genoswitch/software-judging/hardware/hardware/README.md

# hardware

Repository containing the KiCad 7.0 project for the hardware design.

Very early stages of development

## License
This repository is licensed under the **Open Hardware Licence Version 2 - Weakly Reciprocal** (SPDX: `CERN-OHL-W-2.0`)

However, the `lib/` folder contains parts that are subject to their own licenses.
