genoswitch/software-judging/hardware/firmware/src/flashloader/ihex/README.md

The code in this ihex directory is heavily based on the pico-flashloader example implementation available at

https://github.com/rhulme/pico-flashloader/.

pico-flashloader is licensed under BSD-3-Clause.

Therefore, all files in this folder are licensed under BSD-3-Clause.
