genoswitch/software-judging/hardware/hardware/clearances.ods

 | (mm) | PCBWay (absolute min) | PCBWay (recommended, cheaper) | JLCPCB | OSHPark | V-scoring | OLD | HIGHEST
Copper | Minimum clearance | 0.1 | 0.15 |  | 0.1524 |  | 0.1524 | 0.1524
 | Minimum track width | 0.1 | 0.15 | 0.127 | 0.1524 |  | 0.1524 | 0.1524
 | Minimum connection width | 0.1 | 0.15 |  | 0.1524 |  | 0.1524 | 0.1524
 | Minimum annnular width | 0.15 |  | 0.3? | 0.127 |  | 0..13 | 0.15
 | Minimum via diameter |  |  |  | 0.508 |  | 0.508 | 0.508 | 0.6 for matching with annular width
 | Copper to hole clearance |  |  |  | 0.127 |  | 0.127 | 0.127
 | Copper to edge clearance |  |  |  |  | 1 | 0..13 | 1
Holes | Minimum through hole |  |  | 0.3 | 0.254 |  | 0.254 | 0.3
 | Hole to hole clearance |  |  | 0.5 | 0.127 |  | 0.254 | 0.5
uVias | Minimum uVia diameter |  |  | 0.5 | 0.508 |  | 0.508 | 0.508
 | Minimum uVia hole |  |  | 0.3 | 0.254 |  | 0.254 | 0.3
Silkscreen | Minimum item clearance |  |  |  |  |  | 0 | 0
 | Minimum text height | 0.8 |  |  |  |  | 1 | 1
 | Minimum text thickness | 0.15 |  |  | 0.127 |  | 0.153 | 0.153
 |  |  |  |  |  | Annular ring is smallest copper dimension minus by drill diameter divided by two. |  | 0.3
 |  |  |  |  | -0.508 |  | dia | 0.6
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
