genoswitch/software-judging/hardware/hardware/genoswitch-rp2040/genoswitch-rp2040.kicad_pcb

## KiCad design hardware/hardware/genoswitch-rp2040/genoswitch-rp2040.kicad_pcb (2023-10-07)

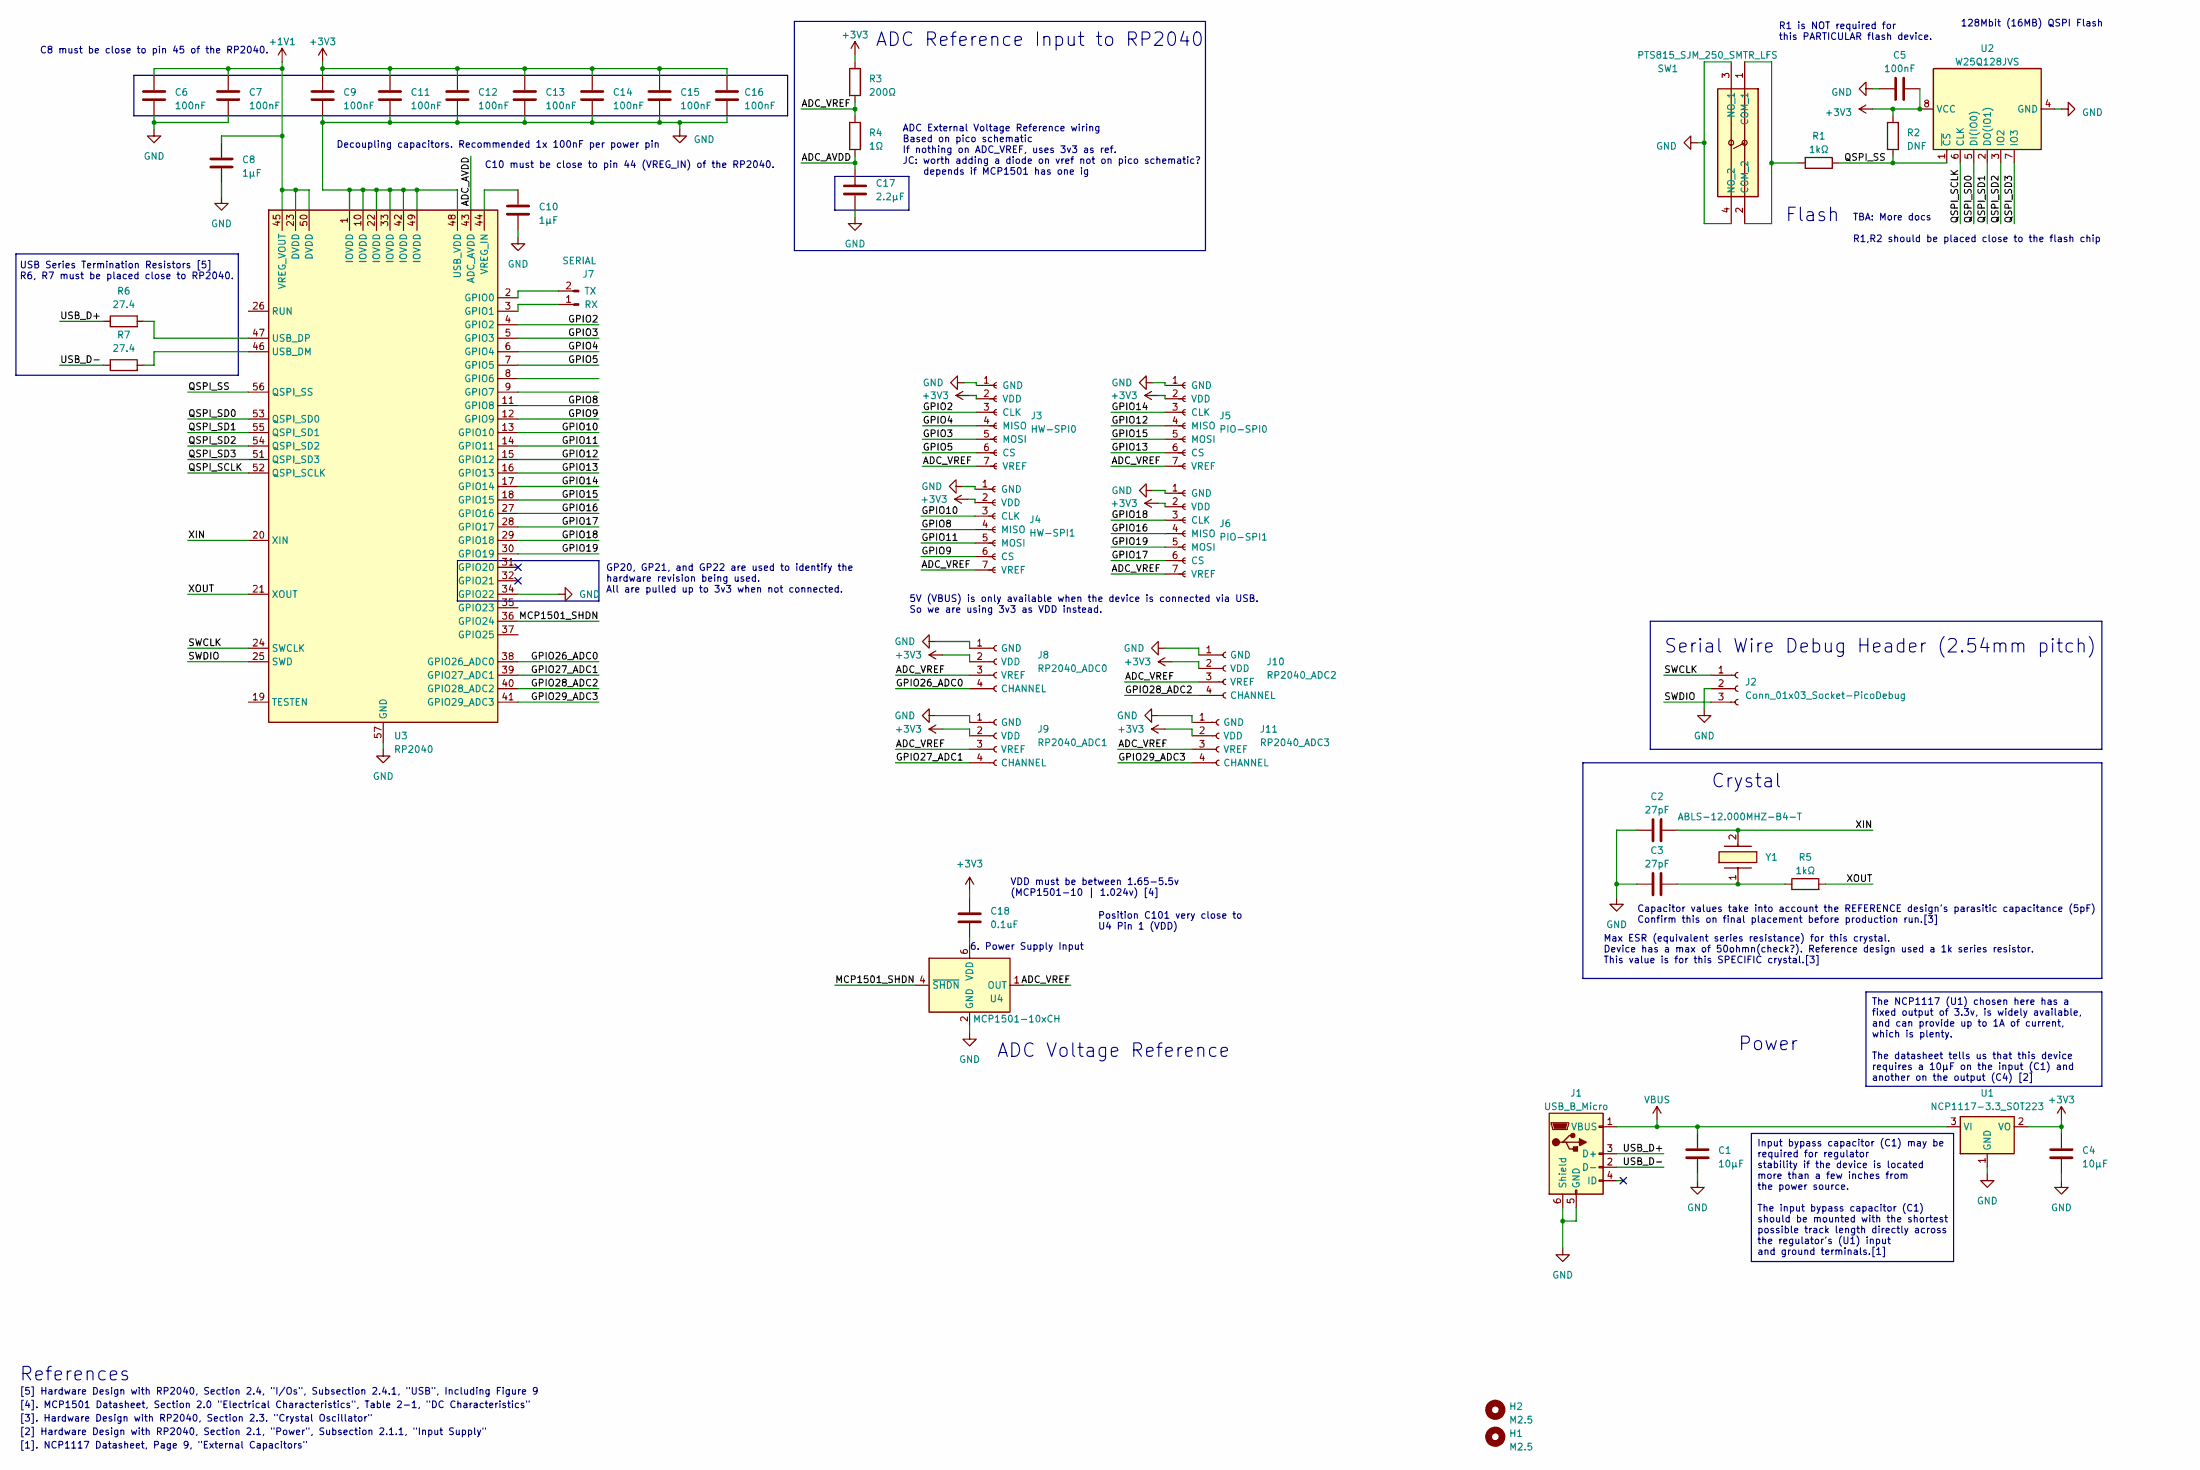
[picture p1: schematic genoswitch-rp2040.kicad_sch]

Parts:
C1, C4: 10μF; C_0201_0603Metric
C2, C3: 27pF; C_0201_0603Metric
C5, C6, C7, C9, C11, C12, C13, C14, C15, C16: 100nF; C_0201_0603Metric
C8, C10: 1μF; C_0201_0603Metric
C17: 2.2μF; C_0201_0603Metric
C18: 0.1uF; C_0201_0603Metric
H1, H2: M2.5; MountingHole_2.7mm_M2.5_Pad_TopBottom
J1: USB_B_Micro; USB_Micro-B_Amphenol_10118193-0001LF_Horizontal
J2: Conn_01x03_Socket-PicoDebug; PinHeader_1x03_P2.54mm_Vertical
J3: HW-SPI0; JST_PH_S7B-PH-K_1x07_P2.00mm_Horizontal
J4: HW-SPI1; JST_PH_S7B-PH-K_1x07_P2.00mm_Horizontal
J5: PIO-SPI0; JST_PH_S7B-PH-K_1x07_P2.00mm_Horizontal
J6: PIO-SPI1; JST_PH_S7B-PH-K_1x07_P2.00mm_Horizontal
J7: SERIAL; PinHeader_1x02_P2.54mm_Vertical
J8: RP2040_ADC0; JST_PH_S4B-PH-K_1x04_P2.00mm_Horizontal
J9: RP2040_ADC1; JST_PH_S4B-PH-K_1x04_P2.00mm_Horizontal
J10: RP2040_ADC2; JST_PH_S4B-PH-K_1x04_P2.00mm_Horizontal
J11: RP2040_ADC3; JST_PH_S4B-PH-K_1x04_P2.00mm_Horizontal
R1, R5: 1kΩ; R_0201_0603Metric
R2: DNF; R_0201_0603Metric
R3: 200Ω; R_0201_0603Metric
R4: 1Ω; R_0201_0603Metric
R6, R7: 27.4; R_0201_0603Metric
SW1: PTS815_SJM_250_SMTR_LFS; PTS815SJM250SMTRLFS; Mouser Part Number 611-PTS815SJM250SMTR
U1: NCP1117-3.3_SOT223; SOT-223-3_TabPin2
U2: W25Q128JVS; SOIC-8_5.23x5.23mm_P1.27mm
U3: RP2040; QFN-56-1EP_7x7mm_P0.4mm_EP3.2x3.2mm
U4: MCP1501-10xCH; SOT-23-6
Y1: ABLS-12.000MHZ-B4-T; ABLS; Mouser Part Number 815-ABLS-12.0M-T

Connections:
+1V1: C6.1, C7.1, C8.1, U3.23 (DVDD), U3.45 (VREG_VOUT), U3.50 (DVDD)
+3V3: C4.1, C5.2, C9.1, C11.1, C12.1, C13.1, C14.1, C15.1, C16.1, C18.2, J3.2 (VDD), J4.2 (VDD), J5.2 (VDD), J6.2 (VDD), J8.2 (VDD), J9.2 (VDD), J10.2 (VDD), J11.2 (VDD), R2.2, R3.1, U1.2 (VO), U2.8 (VCC)
/ADC_AVDD: C17.1, R4.2, U3.43 (ADC_AVDD)
/ADC_VREF: J3.7 (VREF), J4.7 (VREF), J5.7 (VREF), J6.7 (VREF), J8.3 (VREF), J9.3 (VREF), J10.3 (VREF), J11.3 (VREF), R3.2, R4.1, U4.1 (OUT)
/GPIO4: J3.4 (DOUT), U3.6 (GPIO4)
/GPIO5: J3.6 (CS), U3.7 (GPIO5)
/GPIO6: J3.3 (CLK), U3.4 (GPIO2), U3.8 (GPIO6)
/GPIO7: J3.5 (DIN), U3.5 (GPIO3), U3.9 (GPIO7)
/GPIO8: J4.4 (DOUT), U3.11 (GPIO8)
/GPIO9: J4.6 (CS), U3.12 (GPIO9)
/GPIO10: J4.3 (CLK), U3.13 (GPIO10)
/GPIO11: J4.5 (DIN), U3.14 (GPIO11)
/GPIO12: J5.4 (DOUT), U3.15 (GPIO12)
/GPIO13: J5.6 (CS), U3.16 (GPIO13)
/GPIO14: J5.3 (CLK), U3.17 (GPIO14)
/GPIO15: J5.5 (DIN), U3.18 (GPIO15)
/GPIO16: J6.4 (DOUT), U3.27 (GPIO16)
/GPIO17: J6.6 (CS), U3.28 (GPIO17)
/GPIO18: J6.3 (CLK), U3.29 (GPIO18)
/GPIO19: J6.5 (DIN), U3.30 (GPIO19)
/GPIO26_ADC0: J8.4 (CHANNEL), U3.38 (GPIO26_ADC0)
/GPIO27_ADC1: J9.4 (CHANNEL), U3.39 (GPIO27_ADC1)
/GPIO28_ADC2: J10.4 (CHANNEL), U3.40 (GPIO28_ADC2)
/GPIO29_ADC3: J11.4 (CHANNEL), U3.41 (GPIO29_ADC3)
/MCP1501_SHDN: U3.36 (GPIO24), U4.4 (~SHDN)
/QSPI_SCLK: U2.6 (CLK), U3.52 (QSPI_SCLK)
/QSPI_SD0: U2.5 (DI(IO0)), U3.53 (QSPI_SD0)
/QSPI_SD1: U2.2 (DO(IO1)), U3.55 (QSPI_SD1)
/QSPI_SD2: U2.3 (IO2), U3.54 (QSPI_SD2)
/QSPI_SD3: U2.7 (IO3), U3.51 (QSPI_SD3)
/QSPI_SS: R1.1, R2.1, U2.1 (~CS), U3.56 (QSPI_SS)
/SWCLK: J2.1, U3.24 (SWCLK)
/SWDIO: J2.3, U3.25 (SWD)
/USB_D+: J1.3 (D+), R6.1
/USB_D-: J1.2 (D-), R7.1
/XIN: C2.2, U3.20 (XIN), Y1.2
/XOUT: R5.2, U3.21 (XOUT)
GND: C1.2, C2.1, C3.1, C4.2, C5.1, C6.2, C7.2, C8.2, C9.2, C10.2, C11.2, C12.2, C13.2, C14.2, C15.2, C16.2, C17.2, J1.5 (GND), J1.6 (Shield), J2.2, J3.1 (GND), J4.1 (GND), J5.1 (GND), J6.1 (GND), J8.1 (GND), J9.1 (GND), J10.1 (GND), J11.1 (GND), SW1.3 (NO_1), SW1.4 (NO_2), U1.1 (GND), U2.4 (GND), U3.1 (IOVDD), U3.10 (IOVDD), U3.22 (IOVDD), U3.33 (IOVDD), U3.34 (GPIO22), U3.42 (IOVDD), U3.48 (USB_VDD), U3.49 (IOVDD), U3.57 (GND), U4.2 (GND), U4.3 (GND), U4.5 (GND)
unnamed: C3.2, R5.1, Y1.1
unnamed: J7.1 (RX), U3.3 (GPIO1)
unnamed: J7.2 (TX), U3.2 (GPIO0)
unnamed: R1.2, SW1.1 (COM_1), SW1.2 (COM_2)
unnamed: R7.2, U3.46 (USB_DM)
unnamed: R6.2, U3.47 (USB_DP)
unnamed: C10.1, U3.44 (VREG_IN)
unnamed: C18.1, U4.6 (VDD)
VBUS: C1.1, J1.1 (VBUS), U1.3 (VI)

Notes on the sheet:
The NCP1117 (U1) chosen here has a fixed output of 3.3v, is widely available, and can provide up to 1A of current, which is plenty. The datasheet tells us that this device requires a 10μF on the input (C1) and another on the output (C4) [2]
Input bypass capacitor (C1) may be required for regulator stability if the device is located more than a few inches from the power source. The input bypass capacitor (C1) should be mounted with the shortest possible track length directly across the regulator's (U1) input and ground terminals.[1]
VDD must be between 1.65-5.5v (MCP1501-10 | 1.024v) [4]
6. Power Supply Input
5V (VBUS) is only available when the device is connected via USB. So we are using 3v3 as VDD instead.
[4]. MCP1501 Datasheet, Section 2.0 "Electrical Characteristics", Table 2-1, "DC Characteristics"
Position C101 very close to U4 Pin 1 (VDD)
[5] Hardware Design with RP2040, Section 2.4, "I/Os", Subsection 2.4.1, "USB", Including Figure 9
128Mbit (16MB) QSPI Flash
USB Series Termination Resistors [5] R6, R7 must be placed close to RP2040.
[3]. Hardware Design with RP2040, Section 2.3. "Crystal Oscillator"
Decoupling capacitors. Recommended 1x 100nF per power pin
GP20, GP21, and GP22 are used to identify the hardware revision being used. All are pulled up to 3v3 when not connected.
Power
Serial Wire Debug Header (2.54mm pitch)
Crystal
R1 is NOT required for this PARTICULAR flash device.
[1]. NCP1117 Datasheet, Page 9, "External Capacitors"
ADC Voltage Reference
C10 must be close to pin 44 (VREG_IN) of the RP2040.
ADC External Voltage Reference wiring Based on pico schematic If nothing on ADC_VREF, uses 3v3 as ref. JC: worth adding a diode on vref not on pico schematic? depends if MCP1501 has one ig
TBA: More docs R1,R2 should be placed close to the flash chip
C8 must be close to pin 45 of the RP2040.
ADC Reference Input to RP2040
Capacitor values take into account the REFERENCE design's parasitic capacitance (5pF) Confirm this on final placement before production run.[3]
Max ESR (equivalent series resistance) for this crystal. Device has a max of 50ohmn(check?). Reference design used a 1k series resistor. This value is for this SPECIFIC crystal.[3]
Flash
[2] Hardware Design with RP2040, Section 2.1, "Power", Subsection 2.1.1, "Input Supply"
References

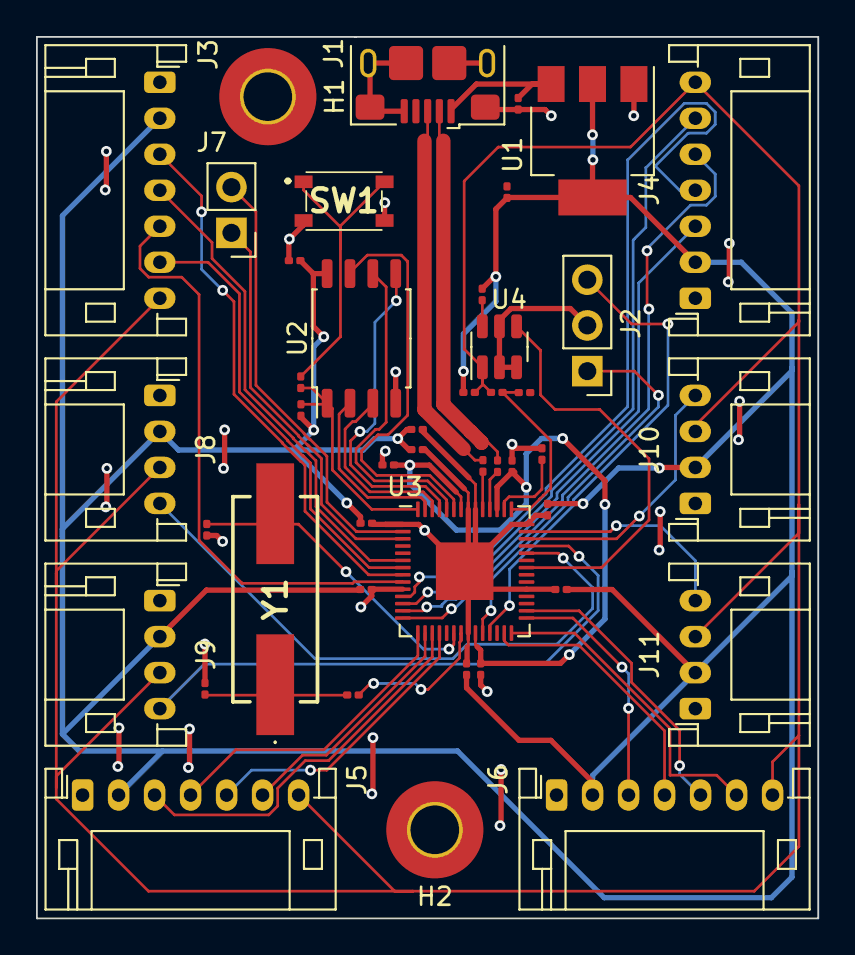
[picture p2: board genoswitch-rp2040.kicad_pcb from above]

Board: 2 copper layers, 43.4 x 49.0 mm, 44 parts (0 on the bottom side), 47 nets.
