genoswitch/software-judging/hardware/firmware/src/flashloader/ihex/util.c

#include <stdint.h>

// Converts an ASCII hex character into its binary representation.
// The existing value is shifted across one nibble before the new value is
// stored in the lower nibble.
// Returns non-zero if the character could be converted
static int hex2nibble(char c, uint8_t *value)
{
    int success = 0;

    if (c >= '0' && c <= '9')
    {
        *value <<= 4;
        *value |= (uint8_t)(c - '0');
        success = 1;
    }
    else
    {
        c |= 32;
        if (c >= 'a' && c <= 'z')
        {
            *value <<= 4;
            *value |= (uint8_t)(c - 'a') + 10;
            success = 1;
        }
    }

    return success;
}

// Converts two ASCII hex characters to an 8-bit binary value.
// Returns non-zero if valid hex characters were found
static int parseHex(const char *str, uint8_t *value)
{
    int success;

    *value = 0;
    success = hex2nibble(*str++, value) && hex2nibble(*str, value);

    return success;
}
