genoswitch/software-judging/(commit log)

2023-01-25 (lib) Add pico-sdk submodule
2023-01-25 Create CMakeList capable of building pico-examples/blink
2023-01-28 Add comments, move prototypes to .h file
2023-01-28 Add tinyusb submodule using master branch
    pico-sdk uses an old version of tinyusb
2023-02-17 Initial support for exchanging messages using a custom request number similar to how webusb landing page(s) are transmitted
2023-02-18 Add unique (board) id vendor command
2023-03-11 POC mcu temp task using ADC channel 4
2023-03-23 (lib) Add pico-flashloader submodule
2023-03-24 (cmake): PoC new way of combining binaries
    This method is based off of picowota (https://github.com/usedbytes/picowota) as well as the pico sdk itself.
    With this method we can create all of the expected output files (.elf, .hex, .uf2) as well as register it as an executable in cmake.
    This commit is just a proof of concept, in later commits this will be extended to have the functionality described above.
2023-03-25 (cmake): Move pico sdk import to root CMakeLists
2023-03-25 (linker): pico-flashloader requires application to have boot2
    Unlike picowota, pico-flashloader uses boot2 to identify the start of image. If space is a concern we could change this behaviour to use a magic string like picowota instead.
2023-04-06 (linker|cmake): Place the flashloader inside the main binary
    In this commit we switch from placing the application in the flashloader to placing the flashloader in the application.
    This makes it easier to debug the application as debug symbols are already in the correct location, at the expense of losing easy debugging for the flashloader.
    Prior to this commit it was difficult to debug the application with the flashloader as the debug symbols did not line up.
2023-04-09 Move core/main files into own directory to prep for library creation
    In this commit I have moved the 'core' code to a seperate folder.
    This is to prep for the creation of a library that can be linked to in order to produce different variants of the firmware (boards, with/without flashloader)
2023-04-09 (core/main): PoC printfs showing flashloader status
2023-04-09 (lib): Update pico-sdk to release v1.5.0
2023-04-09 Use pico optimized versions of standard libraries
2023-04-11 (flashloader): Create DMA standard crc32 func
2023-04-11 (flashloader): Add required tusb dfu callbacks for device to successfully enumerate
    With this commit the device is sucessfully enumerated and now presents a DFU interface. However, on Windows no driver is given to this interface so it cannot be claimed by WebUSB.
    In Linux/macOS, this is not a problem.
    To fix this, we must modify the Microsoft OS 2.0 descriptors to add an additional function subset header for the new interface.
    For more information on the function subset header please visit: https://github.com/newaetech/naeusb/blob/main/wcid.md#function-subset-header
2023-04-11 (core/tusb-conf): Add define scoped MS OS 2.0 values for DFU interface.
    NOTE: At the moment, this change breaks the USB enumeration. I am curious to see if it is because of the size of "desc_ms_os_20".
    Regardless, running this commit results in the pico panicking with the tusb error "ep 0 out was already available".
    I will set up a example version of this so see if it can be duplicated outside of this repo, and if so, submit a bug to TinyUSB.
2023-05-06 (ci): Switch to a matrix, upload artifacts to github pages
2023-05-13 Init KiCad project
    [genoswitch-rp2040.kicad_pcb, genoswitch-rp2040.kicad_sch]
2023-05-13 Add initial power circuitry from minimal design example
    [genoswitch-rp2040.kicad_sch]
2023-05-14 Move power components, add text boxes and references
    [genoswitch-rp2040.kicad_sch]
2023-05-14 Add RP2040 using default package for now
    Note that the minimal example uses a different KiCad package
    [genoswitch-rp2040.kicad_sch]
2023-05-14 Start work on decoupling capacitors for power pins
    [genoswitch-rp2040.kicad_sch]
2023-05-14 Add initial ihex parsing code (based on rhulme/pico-flashloader)
2023-05-15 (lib/pico-flashloader): Switch to fork with patch commit
2023-05-18 (symbols): Split out pins with the same function
    IOVDD, other have multiple pins. On the stock symbol they are combined into a single pin
2023-05-18 Switch to new custom rp2040 part
    [genoswitch-rp2040.kicad_sch]
2023-05-18 Move schematic components around
    [genoswitch-rp2040.kicad_sch]
2023-05-18 Add decoupling capacitors for IOVDD pins
    [genoswitch-rp2040.kicad_sch]
2023-05-18 Add 16MB QSPI chip
    [genoswitch-rp2040.kicad_sch]
2023-05-19 Add crystal (reference design for now)
    [genoswitch-rp2040.kicad_sch]
2023-06-04 (flashloader/ihex/process): Add addr debug print, print ulba when ext lin addr encountered
2023-06-07 (flashloader/ihex/process): Add note about failure condition
    [process.c]
2023-06-07 (flashloader/combined): Create sectioned hex files.
    The stock .hex file contains two sections, the flashloader, starting at 0x10000000, and the application, currently starting at 0x10001000.
    At present only the application is updated when using the DFU mode, so we need a way to only write the application to the flash.
    We could hardcode offsets in the firmware but that would make it difficult when the offset is changed.
    Instead, we are making seperate .hex files for each of the two sections.
    We can then use micro:bit's universal hex format to merge them together in a way where we can clearly identify when each section starts without relying on fixed addresses.
2023-06-08 (flashloader/combined): Use correct env var when printing npm exec path
2023-06-08 (flashloader/main): Switch to crc32 header for include
2023-06-09 (core/main): Print to console if app has updated
2023-06-09 (flashloader/ihex/process): Adjust comments, print debug statements
2023-06-10 (rtos/config): Use a single core for now as tasks are not yet thread-safe
2023-06-10 Add ADC semaphore mutex for mcu_temp task
2023-06-11 Add an MCP1501-10 voltage reference controlled by GP22
    [genoswitch-rp2040.kicad_sch]
2023-06-11 Increase schematic size to A3 (was A4)
    [genoswitch-rp2040.kicad_sch]
2023-06-11 Correctly wire MCP1501 as ADC_VREF based on pico schematic
    [genoswitch-rp2040.kicad_sch]
2023-06-13 Add M2.5 mounting holes (same as Pi Pico)
    [genoswitch-rp2040.kicad_sch]
2023-06-13 Ground RP2040 chip
    [genoswitch-rp2040.kicad_sch]
2023-06-14 (tusb): Switch to new pid.codes pid/vid assignment
2023-06-14 (ci/mirror/merge): Switch to pre-made action
2023-07-10 (lib): Update pico-sdk to version 1.5.1
2023-07-16 note that regulator is U1
    [genoswitch-rp2040.kicad_sch]
2023-07-17 Add a Serial Wire Debug header
    [genoswitch-rp2040.kicad_sch]
2023-07-17 Add HW SPI MCP3008s
    [genoswitch-rp2040.kicad_sch]
2023-07-17 Add PIO SPI MCP3008s
    [genoswitch-rp2040.kicad_sch]
2023-07-17 Change MCP1501_SHDN to GP24
    [genoswitch-rp2040.kicad_sch]
2023-07-18 Add 0201/0603M footprints for resistors, capacitors
    [genoswitch-rp2040.kicad_sch]
2023-07-18 Add footprint for Micro-USB 10118193-0001LF
    [genoswitch-rp2040.kicad_sch]
2023-07-18 Add footprint for C2, C3
    [genoswitch-rp2040.kicad_sch]
2023-07-18 Switch SW1 to PTS815 SJM 250 SMTR LFS; add part library
    [genoswitch-rp2040.kicad_sch]
2023-07-18 (ci/github): Switch to new mirror action
2023-08-05 Move hardware repos to hardware/
    [genoswitch-rp2040.kicad_pcb, genoswitch-rp2040.kicad_sch]
2023-08-07 Add a custom symbol for the B7B-PH-K-S ADC connector
2023-08-07 Remove MCP3008s from main PCB, add connectors instead
    [genoswitch-rp2040.kicad_sch]
2023-08-07 Add missing connections to RP2040 SoC
    [genoswitch-rp2040.kicad_sch]
2023-08-07 Add device detection pin connections
    [genoswitch-rp2040.kicad_sch]
2023-08-08 Add ability to determine device type using 3 GPIOs
2023-08-08 (core/main): Adjust serial printfs
2023-08-08 Change 0603 components to 0402 sizes
    [genoswitch-rp2040.kicad_sch]
2023-08-08 Add serial header to RP2040
    [genoswitch-rp2040.kicad_sch]
2023-08-08 Initial partial layout
    [genoswitch-rp2040.kicad_pcb]
2023-08-08 Place all components in rough positions
    [genoswitch-rp2040.kicad_pcb]
2023-08-08 Swap to horizonal JST PH connector
    [genoswitch-rp2040.kicad_pcb, genoswitch-rp2040.kicad_sch]
2023-08-09 Set clearances, netclass widths using the largest values from PCBWay, JLCPCB and OSHPark
2023-08-09 Route USB Data Lines
    [genoswitch-rp2040.kicad_pcb]
2023-08-09 Add +1v1, VBUS, GND to Power netclass
2023-08-09 move components, slight routing
    [genoswitch-rp2040.kicad_pcb]
2023-08-11 Route U2, SW1 -> RP2040
    [genoswitch-rp2040.kicad_pcb]
2023-08-11 misc layout changes
    [genoswitch-rp2040.kicad_pcb]
2023-08-11 (ADC_CONN): Make GND pin 1
    [genoswitch-rp2040.kicad_pcb, genoswitch-rp2040.kicad_sch]
2023-08-11 Reposition holes
    [genoswitch-rp2040.kicad_pcb]
2023-08-11 Add ADC Channel sockets x4, place on board 5mil apart
    [genoswitch-rp2040.kicad_pcb, genoswitch-rp2040.kicad_sch]
2023-08-11 Revert "Change 0603 components to 0402 sizes"
    This reverts commit b164c8e7de76090c9848900fff1e32a63cc8b3a4.
    [genoswitch-rp2040.kicad_sch]
2023-08-11 Update PCB from schematic for new 0602 sizing
    [genoswitch-rp2040.kicad_pcb]
2023-08-11 Set board outline
    [genoswitch-rp2040.kicad_pcb]
2023-08-11 Move U1 down slightly
    [genoswitch-rp2040.kicad_pcb]
2023-08-11 Add missing decoupling cap for 7th power pin, renumber C16->C17, C101->C18
    [genoswitch-rp2040.kicad_sch]
2023-08-11 Update PCB from schematic (see prev commit)
    [genoswitch-rp2040.kicad_pcb]
2023-08-11 (schematic): Add R6, R7 series termination resistors
    TODO: document in schematic
    [genoswitch-rp2040.kicad_sch]
2023-08-11 Assign footprints, add notes to R6,R7
    [genoswitch-rp2040.kicad_sch]
2023-08-11 Initial routing of C6, C15, C16, R6, R7
    [genoswitch-rp2040.kicad_pcb]
2023-08-11 Route other resistors, caps on RP2040
    [genoswitch-rp2040.kicad_pcb]
2023-08-11 Place capacitor C4, move U1 text
    [genoswitch-rp2040.kicad_pcb]
2023-08-11 Route U4, ADC_VREF around edge, ADC_AVDD
    [genoswitch-rp2040.kicad_pcb]
2023-08-11 Snake +3v3 across the board
    [genoswitch-rp2040.kicad_pcb]
2023-08-11 Have U4 be powered by +3v3
    [genoswitch-rp2040.kicad_pcb, genoswitch-rp2040.kicad_sch]
2023-08-11 Route TX,RX pin header
    [genoswitch-rp2040.kicad_pcb]
2023-08-11 Route J3 (HW-SPI0)
    [genoswitch-rp2040.kicad_pcb]
2023-08-11 Route J4,J5,J6
    [genoswitch-rp2040.kicad_pcb]
2023-08-11 Route SWD header
    [genoswitch-rp2040.kicad_pcb]
2023-08-11 Place Y1 next to RP2040, route traces around it
    [genoswitch-rp2040.kicad_pcb]
2023-08-11 Shift area around U2,Y1 to fit better
    [genoswitch-rp2040.kicad_pcb]
2023-08-11 misc drc fixes (empty traces)
    [genoswitch-rp2040.kicad_pcb]
2023-08-11 Add clearances.ods, update design rules for kicad project
    [clearances.ods]
2023-08-11 Update via sizes
    [genoswitch-rp2040.kicad_pcb]
2023-08-11 Account for min annular width for vias
    [clearances.ods, genoswitch-rp2040.kicad_pcb]
2023-08-11 (chore): Fix non-outline DRC errors
    [genoswitch-rp2040.kicad_pcb]
2023-08-11 Commit .kicad_pro file for 7dc94fe898b3e63f5aeb923815829955d28dfb08
2023-08-11 (clearances.ods): Note where 1mm requirements comes from
    [clearances.ods]
2023-08-11 Re-trace board outline rails to adhere to new DRC rules
    [genoswitch-rp2040.kicad_pcb]
2023-08-11 Finished first page of GUI, added colour scheme, added functionality to all the buttons to add and remove miRNA.
2023-08-12 Shift J5, J6 by 90 degrees to make board slightly smaller
    [genoswitch-rp2040.kicad_pcb]
2023-08-12 Connect some power rails
    [genoswitch-rp2040.kicad_pcb]
2023-08-12 Route 1v1 rail, 3v3 links between U1 outputs
    [genoswitch-rp2040.kicad_pcb]
2023-08-12 Route ADC pins to headers
    [genoswitch-rp2040.kicad_pcb]
2023-08-12 Adjust positioning of +3v3 rail near U2
    [genoswitch-rp2040.kicad_pcb]
2023-08-12 Define a ground plane fill
    [genoswitch-rp2040.kicad_pcb]
2023-08-13 Add ground fill, ground C6-C16
    [genoswitch-rp2040.kicad_pcb]
2023-08-13 Route more grounds
    [genoswitch-rp2040.kicad_pcb]
2023-08-13 Fix thermal relief on J2 GND
    [genoswitch-rp2040.kicad_pcb]
2023-08-13 Fix thermal relief on J5 GND
    [genoswitch-rp2040.kicad_pcb]
2023-08-13 Remove unncessary trace
    [genoswitch-rp2040.kicad_pcb]
2023-08-13 Add tracks to lower ground plane resistance where the plane is interrupted
    [genoswitch-rp2040.kicad_pcb]
2023-08-13 Adjust routing of +3V3 rail
    [genoswitch-rp2040.kicad_pcb]
2023-08-13 Exclude SWD header from pos files, bom (DNP)
    [genoswitch-rp2040.kicad_pcb]
2023-08-17 (ci/github/kibot): Update schematic paths; job name
2023-08-17 (ci/github/kibot): Use KiCad 7 action
2023-08-17 Remove old generated folders to prep for new method
    [clearances.ods, genoswitch-rp2040.kicad_pcb, genoswitch-rp2040.kicad_sch]
2023-08-24 (frontend/components): Prelimary info card with device type
2023-08-28 (rp2040): Make screw hioles conductive on both layers
    [genoswitch-rp2040.kicad_pcb, genoswitch-rp2040.kicad_sch]
2023-10-01 PoC SPI communication using PIO
2023-10-01 Don't fill chpa, cpol with programs, remove printf
2023-10-01 Update pinouts for GS connectors -> SPI
    [genoswitch-rp2040.kicad_sch]
2023-10-01 Fix function header name
    [mcp3008_hardware.h]
2023-10-01 Don't use hardcoded pin arrangements
2023-10-05 (core/mcp3008/pio): Attempt to set SPI clock speed
2023-10-07 Add AppImage building using GitHub Actions; remove unneeded files (#1)
    * Move files to src/
    * Initial make appimage script
    * (ci/github): Initial build script
    * Remove python venv dep
    * (make-appimage) set -e
    * (build): misc fixes
    * (ci/github): Fix syntax
    * remove -t
    * Add --privileged
    * (make-appimage): Don't overwrite existing binaries
    * Switch to arch to build for easier font management
    * Install which package
    * Remove unused files
    * Add fonts, don't use pamac
    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
2023-10-07 (pcb): Add approximations of missing 3d models from kicad builtin lib
    [genoswitch-rp2040.kicad_pcb]
